ScatteredDrifter/Adalyn/STL/Plate-Stab_Cutout.stl

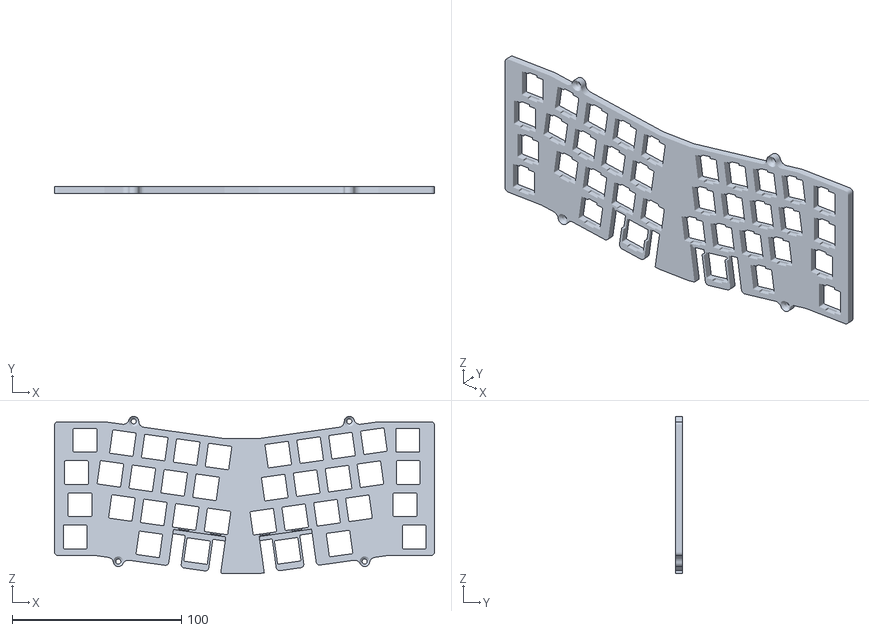
[picture p1: CAD file, 2022-04-01]
STL/Plate-Stab_Cutout.stl
224.8 x 4.00 x 93.1
