ScatteredDrifter/Adalyn/PCB/Adalyn.kicad_sch

## KiCad design PCB/Adalyn.kicad_sch (2022-03-15)

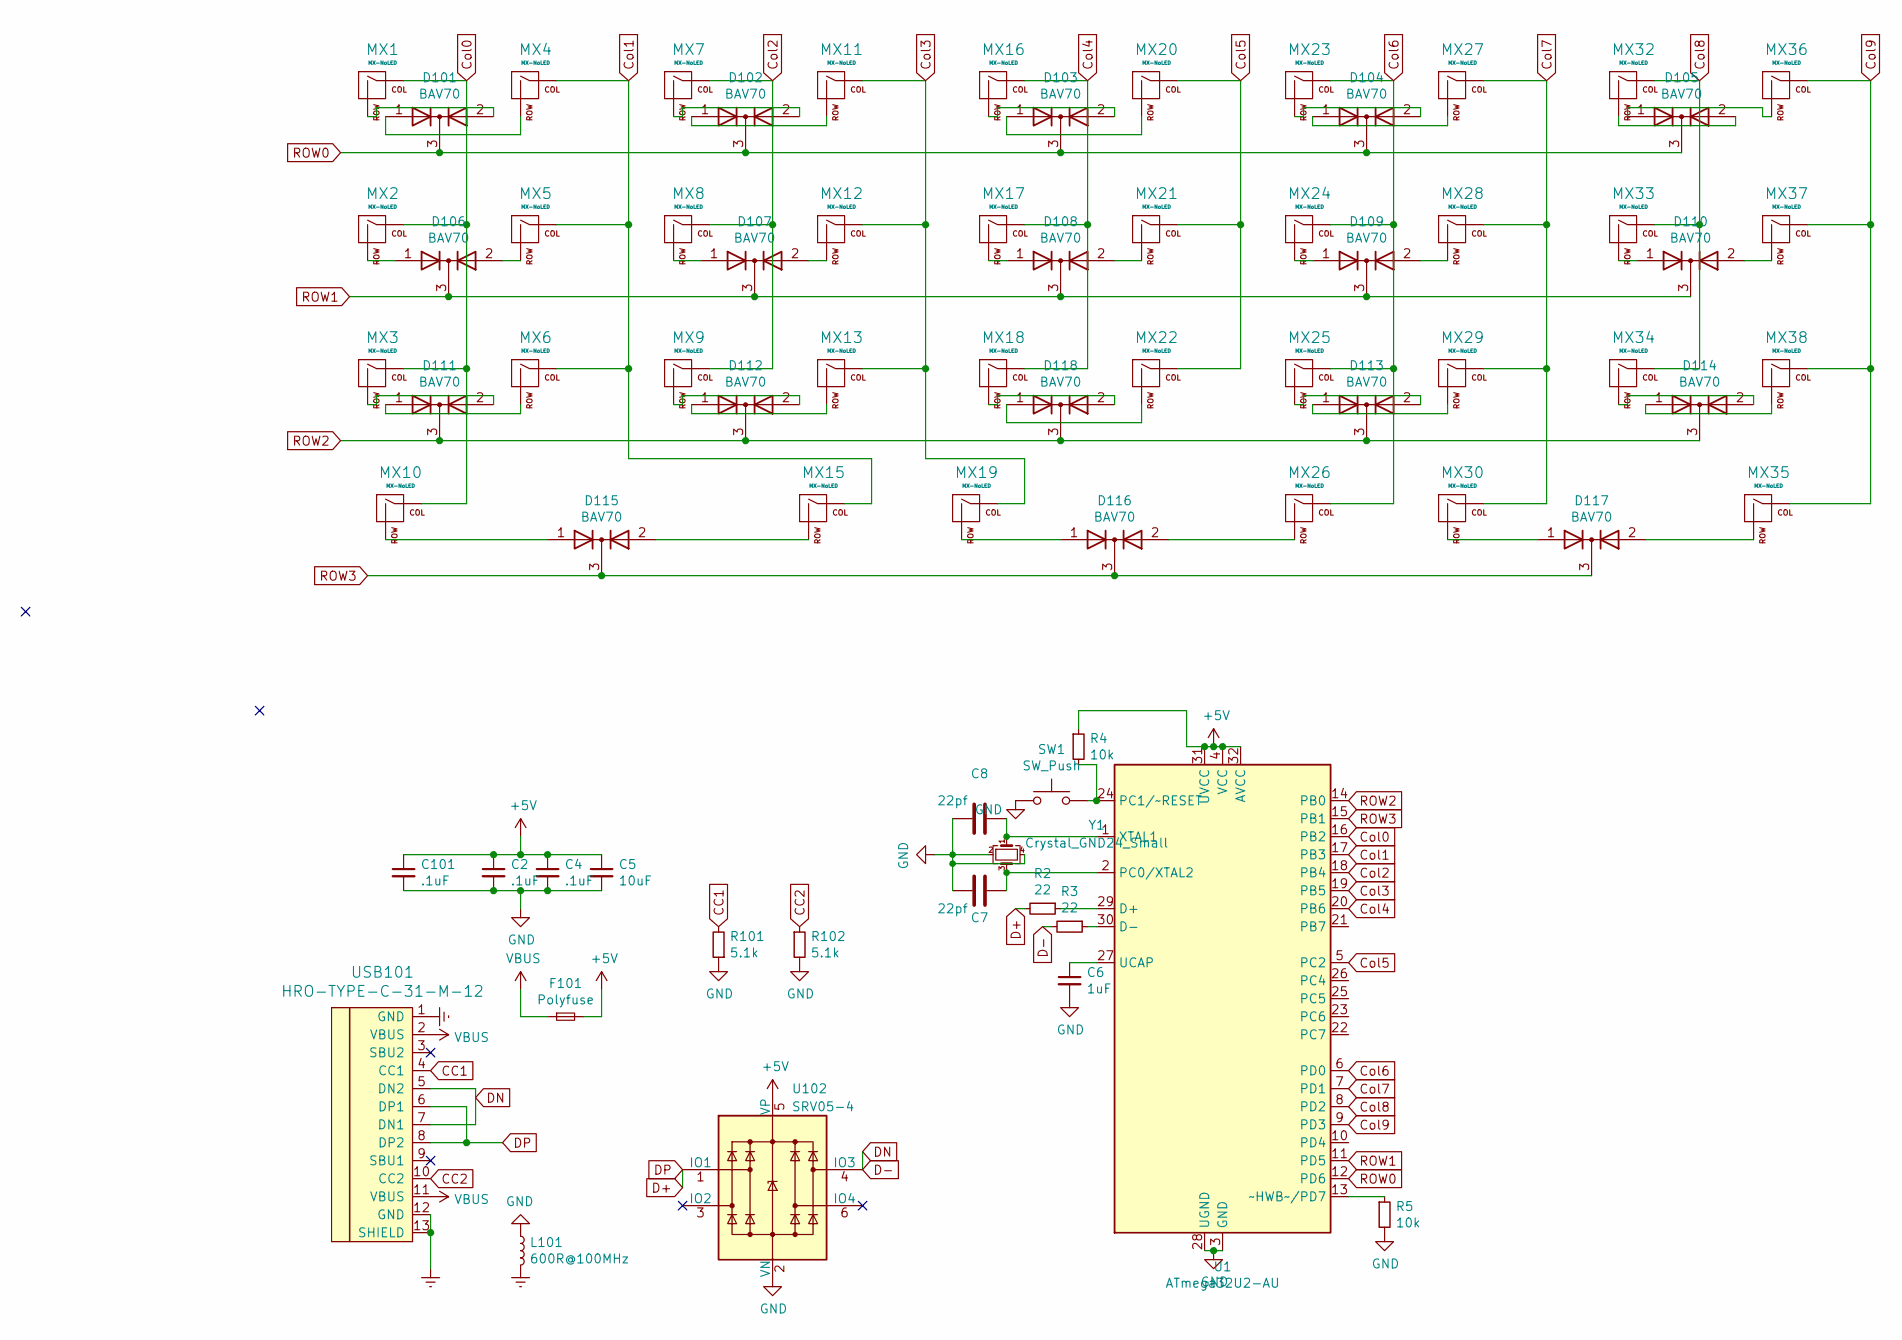
[picture p2: schematic Adalyn.kicad_sch]

Parts:
C2, C4, C101: .1uF; C_0805_2012Metric; LCSC C49678
C5: 10uF; C_0805_2012Metric; LCSC C91245
C6: 1uF; C_0805_2012Metric; LCSC C28323
C7, C8: 22pf; C_0805_2012Metric; LCSC C1804
D101, D102, D103, D104, D105, D106, D107, D108, D109, D110, D111, D112, D113, D114, D115, D116, D117, D118: BAV70; SOT-23; LCSC C68978
F101: Polyfuse; Fuse_1206_3216Metric; LCSC C69688
L101: 600R@100MHz; L_0603_1608Metric
MX1, MX2, MX3, MX4, MX5, MX6, MX7, MX8, MX9, MX10, MX11, MX12, MX13, MX15, MX16, MX17, MX18, MX19, MX20, MX21, MX22, MX23, MX24, MX25, MX26, MX27, MX28, MX29, MX30, MX32, MX33, MX34, MX35, MX36, MX37, MX38: MX-NoLED; SW_MX_1u
R2, R3: 22; R_0805_2012Metric; LCSC C17561
R4, R5: 10k; R_0805_2012Metric; LCSC C17414
R101, R102: 5.1k; R_0805_2012Metric; LCSC C27834
SW1: SW_Push; SW_SPST_TL3342; LCSC C318884
U1: ATmega32U2-AU; TQFP-32_7x7mm_P0.8mm; LCSC C618733
U102: SRV05-4; SOT-23-6
USB101: HRO-TYPE-C-31-M-12; HRO-TYPE-C-31-M-12-Assembly; LCSC C165948
Y1: Crystal_GND24_Small; Crystal_SMD_3225-4Pin_3.2x2.5mm; LCSC C13738

Connections:
+5V: C2.1, C4.1, C5.1, C101.1, F101.2, R4.1, U1.4 (VCC), U1.31 (UVCC), U1.32 (AVCC), U102.5 (VP)
CC1: R101.2, USB101.4 (CC1)
CC2: R102.1, USB101.10 (CC2)
Col0: MX1.1 (COL), MX2.1 (COL), MX3.1 (COL), MX10.1 (COL), U1.16 (PB2)
Col1: MX4.1 (COL), MX5.1 (COL), MX6.1 (COL), MX15.1 (COL), U1.17 (PB3)
Col2: MX7.1 (COL), MX8.1 (COL), MX9.1 (COL), U1.18 (PB4)
Col3: MX11.1 (COL), MX12.1 (COL), MX13.1 (COL), MX19.1 (COL), U1.19 (PB5)
Col4: MX16.1 (COL), MX17.1 (COL), MX18.1 (COL), U1.20 (PB6)
Col5: MX20.1 (COL), MX21.1 (COL), MX22.1 (COL), U1.5 (PC2)
Col6: MX23.1 (COL), MX24.1 (COL), MX25.1 (COL), MX26.1 (COL), U1.6 (PD0)
Col7: MX27.1 (COL), MX28.1 (COL), MX29.1 (COL), MX30.1 (COL), U1.7 (PD1)
Col8: MX32.1 (COL), MX33.1 (COL), MX34.1 (COL), U1.8 (PD2)
Col9: MX35.1 (COL), MX36.1 (COL), MX37.1 (COL), MX38.1 (COL), U1.9 (PD3)
D+: R2.2, U102.1 (IO1), USB101.6 (DP1), USB101.8 (DP2)
D-: R3.2, U102.4 (IO3), USB101.5 (DN2), USB101.7 (DN1)
Earth: L101.2, USB101.1 (GND), USB101.12 (GND), USB101.13 (SHIELD)
GND: C2.2, C4.2, C5.2, C6.2, C7.1, C8.1, C101.2, L101.1, R5.2, R101.1, R102.2, SW1.1, U1.3 (GND), U1.28 (UGND), U102.2 (VN), Y1.2, Y1.4
unnamed: C6.1, U1.27 (UCAP)
unnamed: C7.2, U1.2 (PC0/XTAL2), Y1.3
unnamed: C8.2, U1.1 (XTAL1), Y1.1
unnamed: D101.1 (A), MX4.2 (ROW)
unnamed: D101.2 (A), MX1.2 (ROW)
unnamed: D102.1 (A), MX11.2 (ROW)
unnamed: D102.2 (A), MX7.2 (ROW)
unnamed: D103.1 (A), MX20.2 (ROW)
unnamed: D103.2 (A), MX16.2 (ROW)
unnamed: D104.1 (A), MX27.2 (ROW)
unnamed: D104.2 (A), MX23.2 (ROW)
unnamed: D105.1 (A), MX36.2 (ROW)
unnamed: D105.2 (A), MX32.2 (ROW)
unnamed: D106.1 (A), MX2.2 (ROW)
unnamed: D106.2 (A), MX5.2 (ROW)
unnamed: D107.1 (A), MX8.2 (ROW)
unnamed: D107.2 (A), MX12.2 (ROW)
unnamed: D108.1 (A), MX17.2 (ROW)
unnamed: D108.2 (A), MX21.2 (ROW)
unnamed: D109.1 (A), MX24.2 (ROW)
unnamed: D109.2 (A), MX28.2 (ROW)
unnamed: D110.1 (A), MX33.2 (ROW)
unnamed: D110.2 (A), MX37.2 (ROW)
unnamed: D111.1 (A), MX6.2 (ROW)
unnamed: D111.2 (A), MX3.2 (ROW)
unnamed: D112.1 (A), MX13.2 (ROW)
unnamed: D112.2 (A), MX9.2 (ROW)
unnamed: D113.1 (A), MX29.2 (ROW)
unnamed: D113.2 (A), MX25.2 (ROW)
unnamed: D114.1 (A), MX38.2 (ROW)
unnamed: D114.2 (A), MX34.2 (ROW)
unnamed: D115.1 (A), MX10.2 (ROW)
unnamed: D115.2 (A), MX15.2 (ROW)
unnamed: D116.1 (A), MX19.2 (ROW)
unnamed: D116.2 (A), MX26.2 (ROW)
unnamed: D117.1 (A), MX30.2 (ROW)
unnamed: D117.2 (A), MX35.2 (ROW)
unnamed: D118.1 (A), MX22.2 (ROW)
unnamed: D118.2 (A), MX18.2 (ROW)
unnamed: R2.1, U1.29 (D+)
unnamed: R3.1, U1.30 (D-)
unnamed: R4.2, SW1.2, U1.24 (PC1/~RESET)
unnamed: R5.1, U1.13 (~HWB~/PD7)
ROW0: D101.3 (K), D102.3 (K), D103.3 (K), D104.3 (K), D105.3 (K), U1.12 (PD6)
ROW1: D106.3 (K), D107.3 (K), D108.3 (K), D109.3 (K), D110.3 (K), U1.11 (PD5)
ROW2: D111.3 (K), D112.3 (K), D113.3 (K), D114.3 (K), D118.3 (K), U1.14 (PB0)
ROW3: D115.3 (K), D116.3 (K), D117.3 (K), U1.15 (PB1)
VBUS: F101.1, USB101.2 (VBUS), USB101.11 (VBUS)
