ScatteredDrifter/Adalyn/(commit log)

2022-03-12 fixed firmware
    [Adalyn.kicad_sch]
2022-03-15 updated and fixed firmware position in vial
    [Adalyn.kicad_sch]
2022-04-01 added plate with stabilizier cutout
    [Plate-Stab_Cutout.stl]
